andrewgond/oscilliscope/(list of files, cad)

Other CAD files:
Andrew Block 1 v1 v24.f3d
